vooon/smart-roller-gate-controller/README.md

# smart-roller-gate-controller
ESP32 based roller gate controller with ZigBee remotes
