vooon/smart-roller-gate-controller/hw/smart-roller-gate-controller/release/v1.0/brd-v1.0.pdf

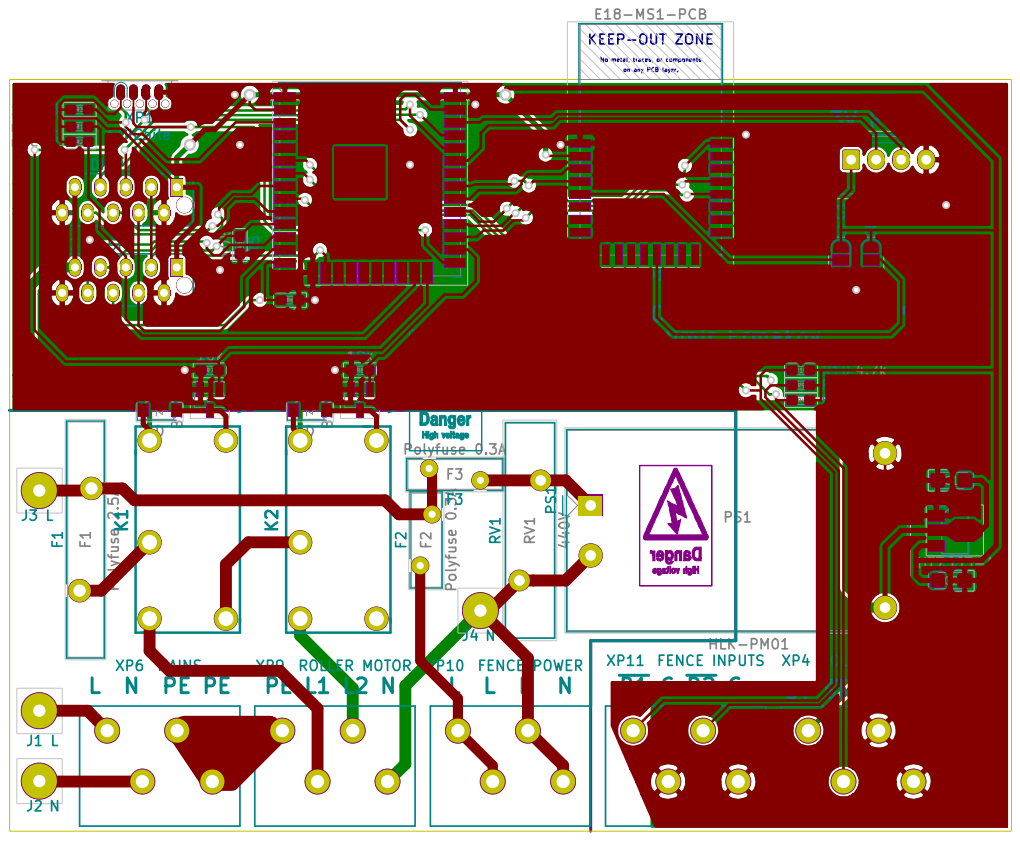
[picture p1: page 1]
