vooon/smart-roller-gate-controller/hw/smart-roller-gate-controller/release/v1.0/sch-v1.0.pdf

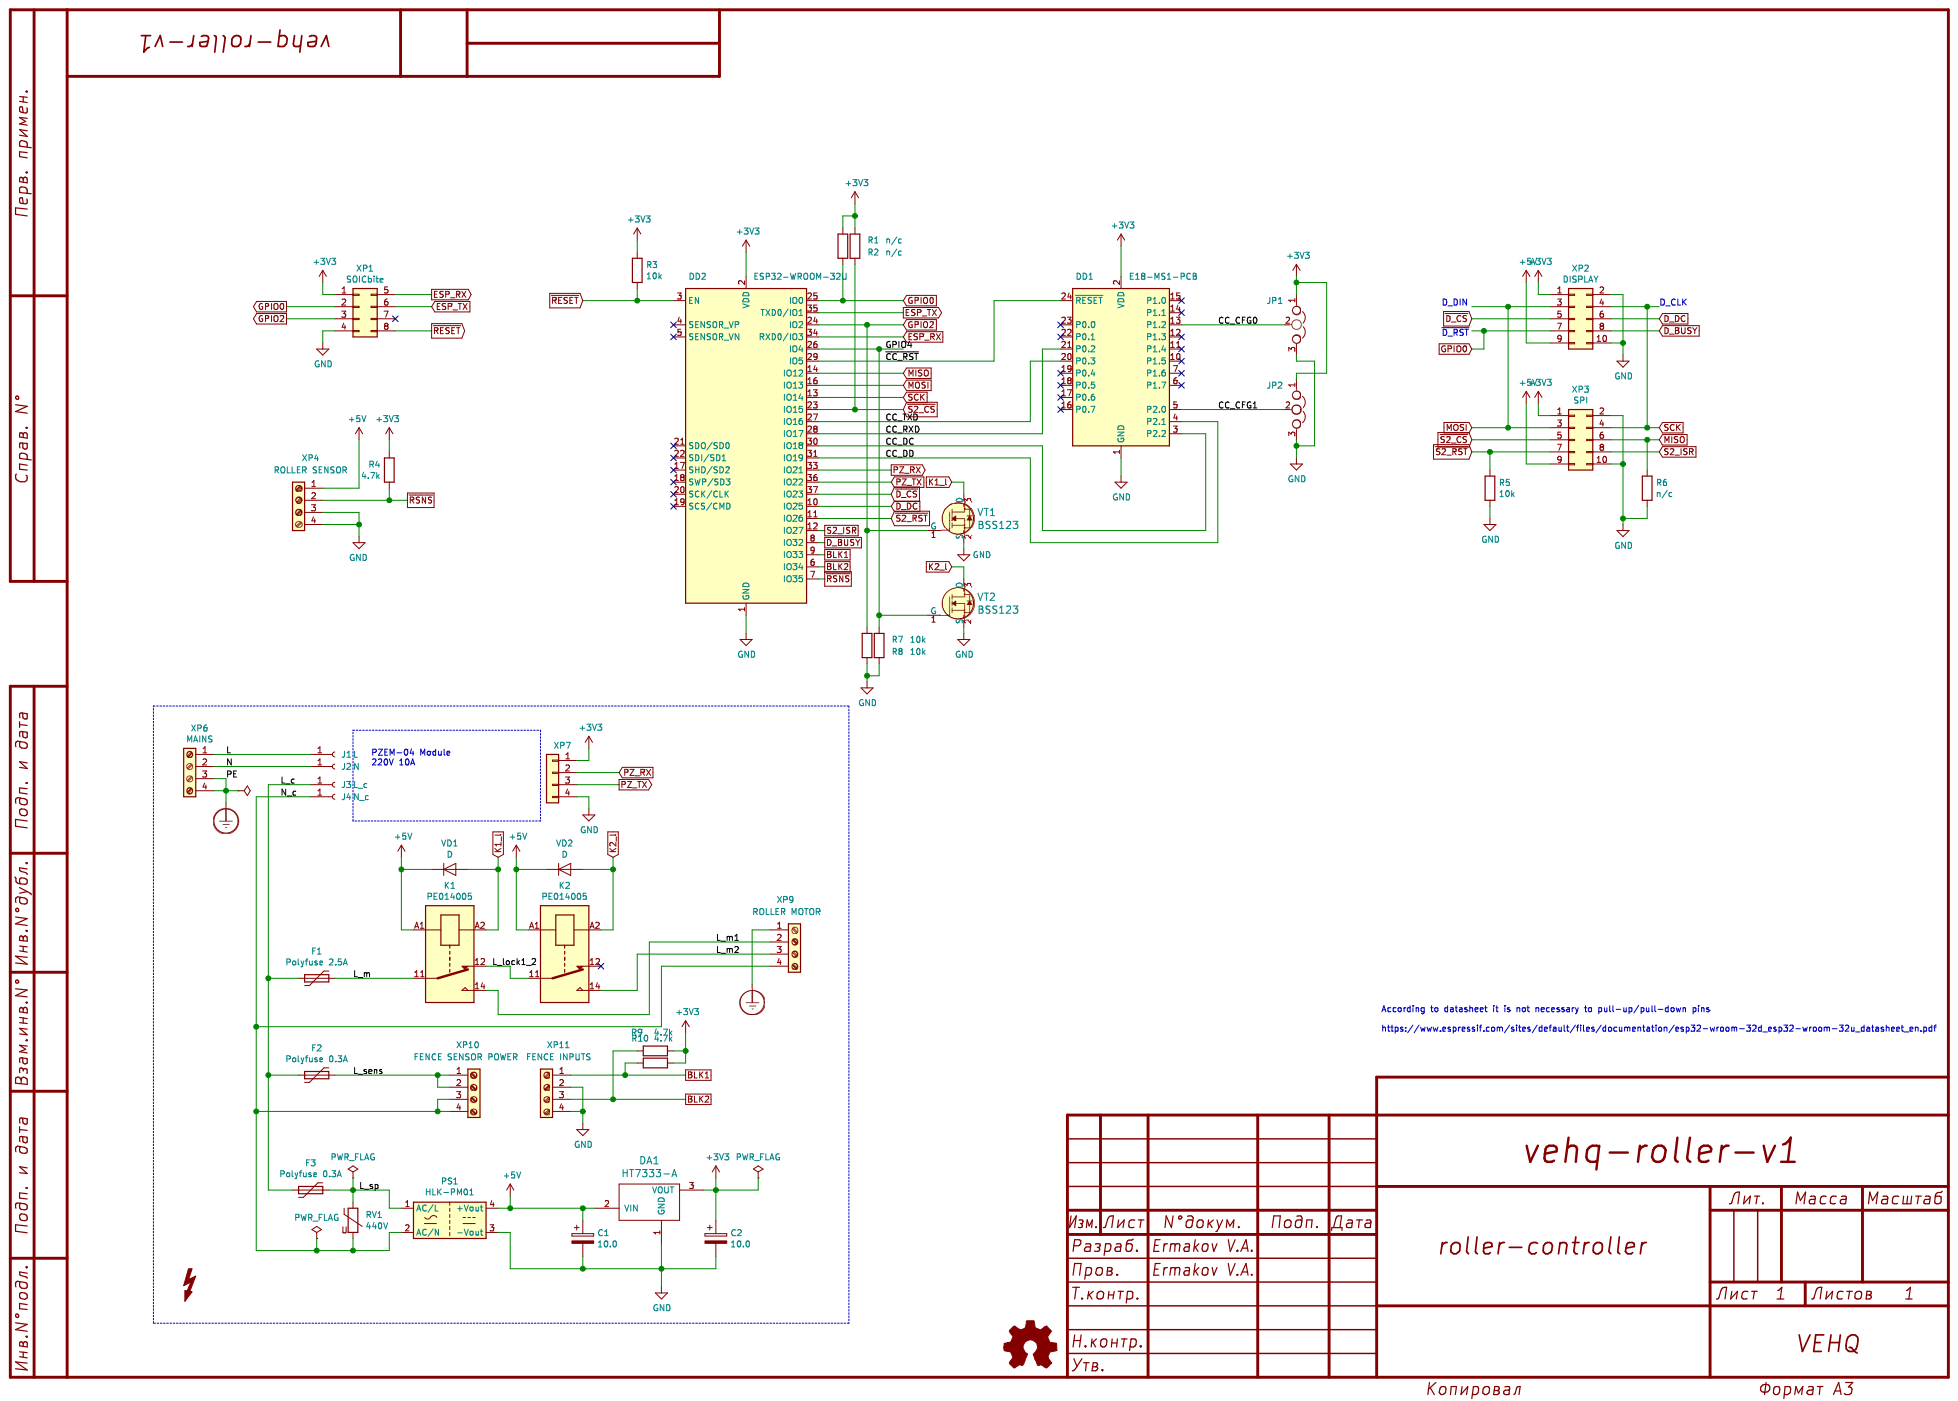
[picture p2: page 1]
