vooon/smart-roller-gate-controller/hw/smart-roller-gate-controller/smart-roller-gate-controller.kicad_pcb

## KiCad design hw/smart-roller-gate-controller/smart-roller-gate-controller.kicad_pcb (2020-01-26)

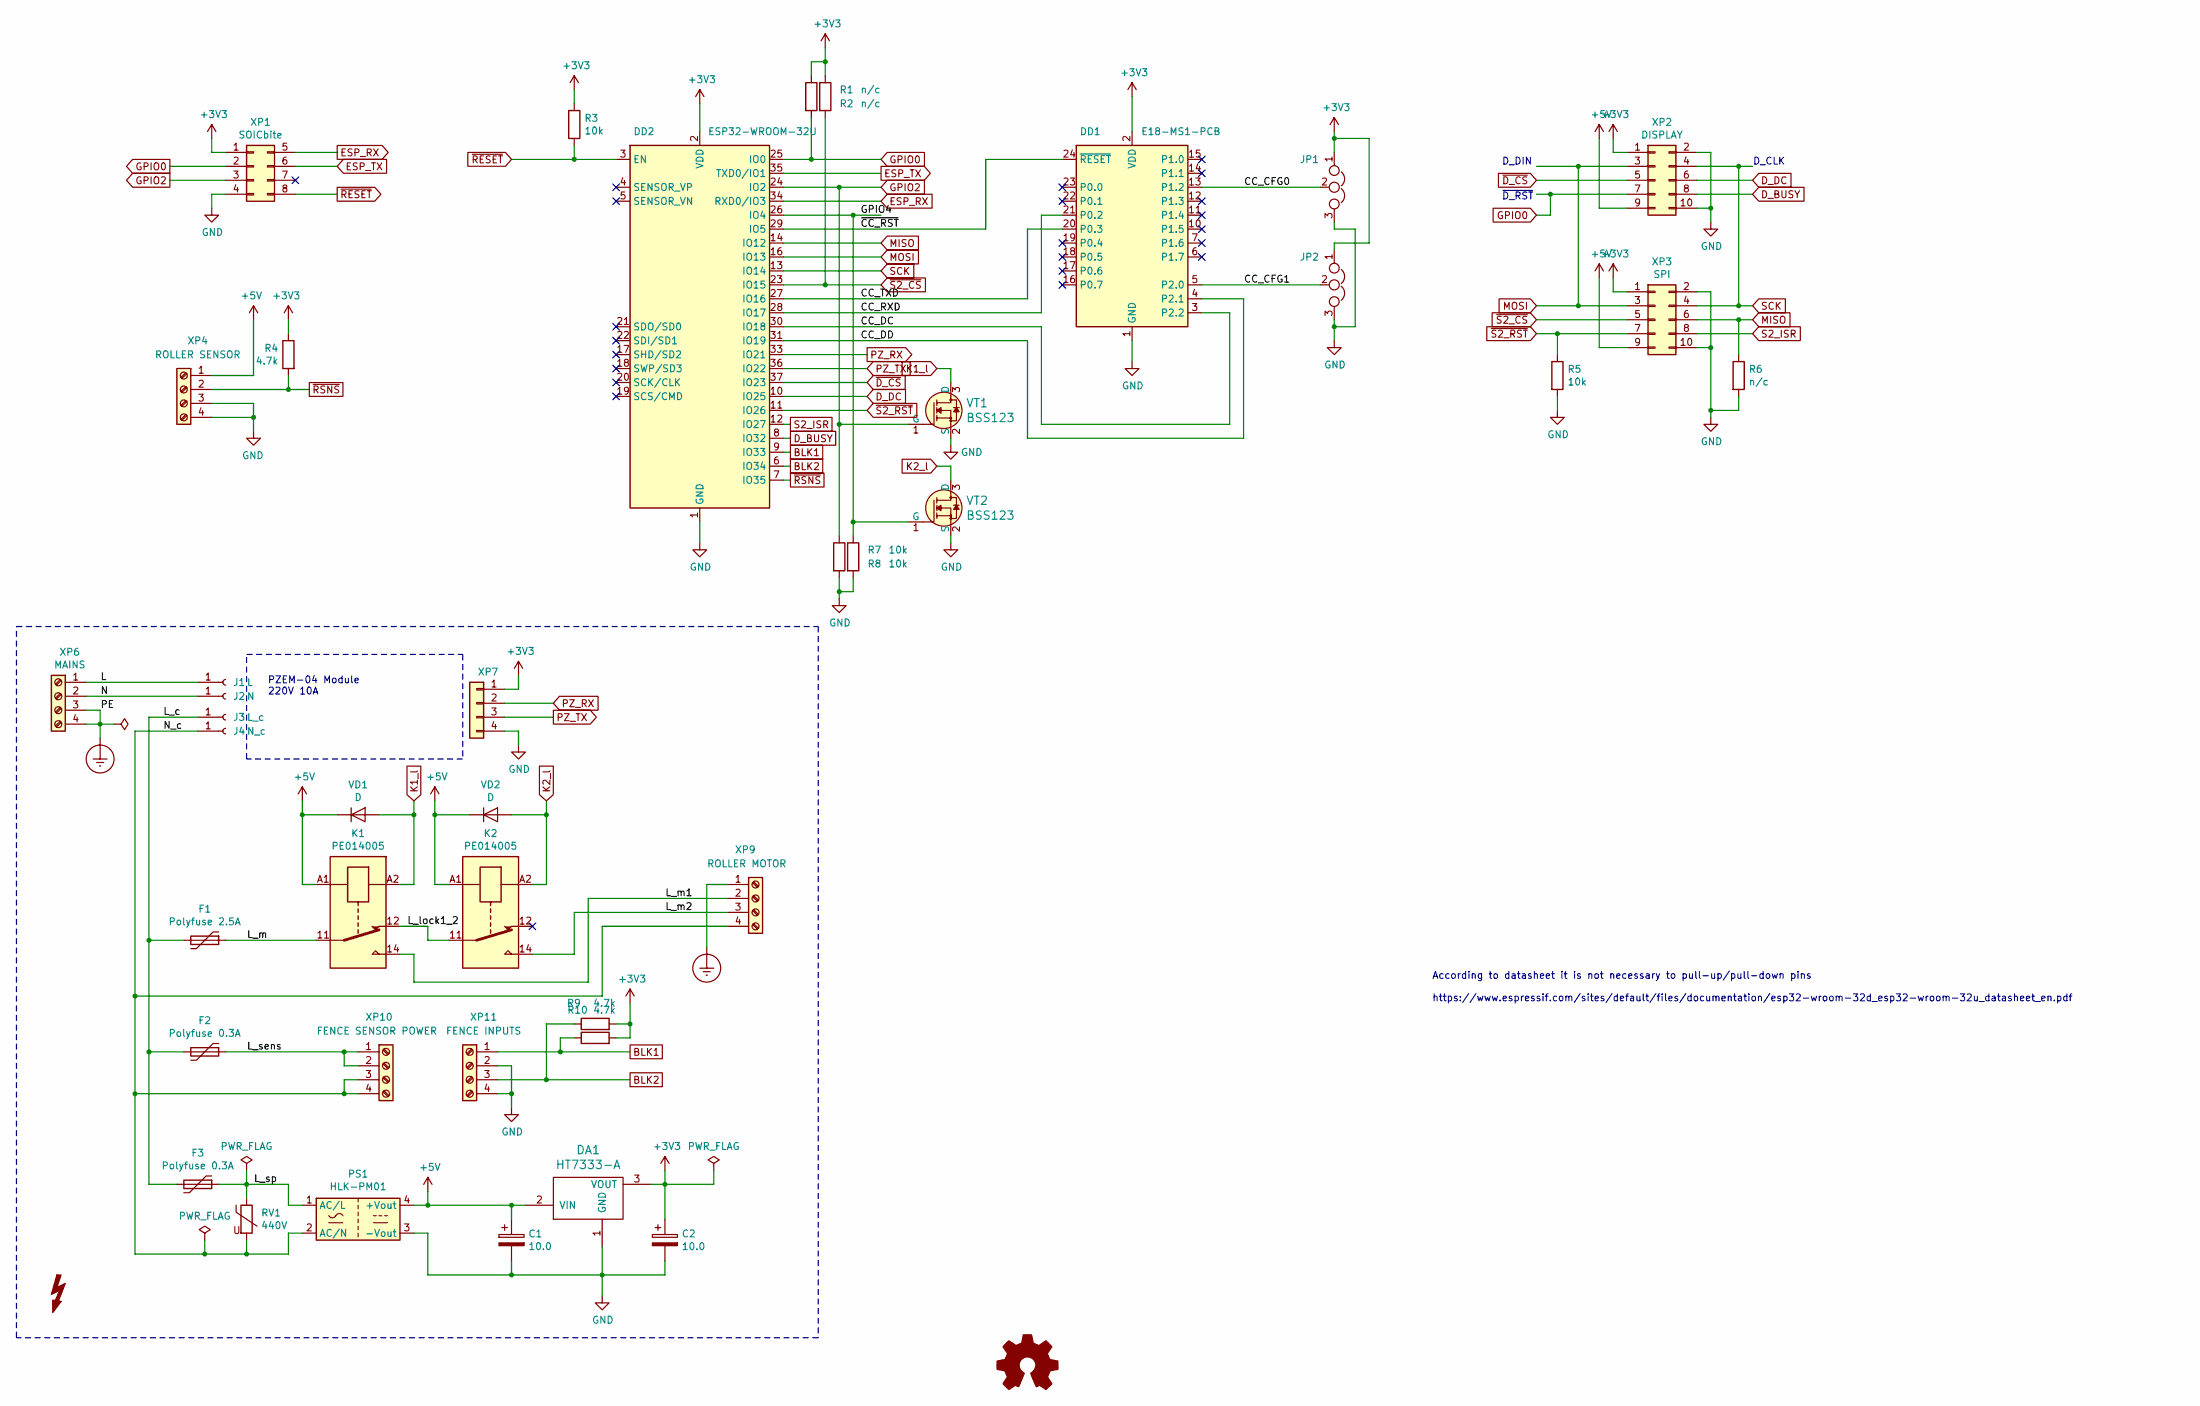
[picture p3: schematic smart-roller-gate-controller.sch, roller-controller]

Parts:
C1, C2: 10.0; CP_EIA-3216-10_Kemet-I
DA1: HT7333-A; SOT-89-3
DD1: E18-MS1-PCB
DD2: ESP32-WROOM-32U
F1: Polyfuse 2.5A; Fuse_Bourns_MF-RHT1300
F2, F3: Polyfuse 0.3A; Fuse_Bourns_MF-RHT200
J1: L; SolderWirePad_1x01_Drill1.2mm
J2: N; SolderWirePad_1x01_Drill1.2mm
J3: L_c; SolderWirePad_1x01_Drill1.2mm
J4: N_c; SolderWirePad_1x01_Drill1.2mm
JP1, JP2: Jumper_NC_Dual; SolderJumper-3_P1.3mm_Open_RoundedPad1.0x1.5mm
K1, K2: PE014005
PS1: HLK-PM01; Converter_ACDC_HiLink_HLK-PMxx
R1, R2, R6: n/c; R_0603_1608Metric_Pad1.05x0.95mm_HandSolder
R3, R5, R7, R8: 10k; R_0603_1608Metric_Pad1.05x0.95mm_HandSolder
R4, R9, R10: 4.7k; R_0603_1608Metric_Pad1.05x0.95mm_HandSolder
RV1: 440V; RV_Disc_D21.5mm_W4.9mm_P10mm
VD1, VD2: D; D_SOD-123
VT1, VT2: BSS123; SOT-23-3; MPN BSS123; Digi-Key_PN BSS123NCT-ND
XP1: SOICbite; SOIC_clipProgSmall
XP2: DISPLAY; CONN-TE-MICROMATCH-5X2-PTH-BOSS
XP3: SPI; CONN-TE-MICROMATCH-5X2-PTH-BOSS
XP4: ROLLER SENSOR; CONN-KF250-BA-4
XP6: MAINS; CONN-KF250-BA-4
XP7: Conn_01x04; JST_XH_B4B-XH-A_1x04_P2.50mm_Vertical
XP9: ROLLER MOTOR; CONN-KF250-BA-4
XP10: FENCE SENSOR POWER; CONN-KF250-BA-4
XP11: FENCE INPUTS; CONN-KF250-BA-4

Connections:
+3V3: C2.1, DA1.3 (VOUT), DD1.2 (VDD), DD2.2 (VDD), JP1.1, JP2.1, R1.1, R2.1, R3.1, R4.1, R9.2, R10.2, XP1.1, XP2.1, XP3.1, XP7.1
+5V: C1.1, DA1.2 (VIN), K1.A1, K2.A1, PS1.4 (+Vout), VD1.1 (K), VD2.1 (K), XP2.9, XP3.9, XP4.1
/CC_CFG0: DD1.13 (P1.2), JP1.2
/CC_CFG1: DD1.5 (P2.0), JP2.2
/CC_DC: DD1.3 (P2.2), DD2.30 (IO18)
/CC_DD: DD1.4 (P2.1), DD2.31 (IO19)
/CC_RXD: DD1.21 (P0.2), DD2.28 (IO17)
/CC_TXD: DD1.20 (P0.3), DD2.27 (IO16)
/GPIO4: DD2.26 (IO4), R8.1, VT2.1 (G)
/L: J1.1, XP6.1
/L_c: F1.2, F2.2, F3.2, J3.1
/L_lock1_2: K1.12, K2.11
/L_m: F1.1, K1.11
/L_m1: K1.14, XP9.2
/L_m2: K2.14, XP9.3
/L_sens: F2.1, XP10.1, XP10.2
/L_sp: F3.1, PS1.1 (AC/L), RV1.1
/N: J2.1, XP6.2
/N_c: J4.1, PS1.2 (AC/N), RV1.2, XP9.4, XP10.3, XP10.4
/~CC_RST: DD1.24 (~RESET), DD2.29 (IO5)
BLK1: DD2.9 (IO33), R10.1, XP11.1
BLK2: DD2.6 (IO34), R9.1, XP11.3
D_BUSY: DD2.8 (IO32), XP2.8
D_DC: DD2.10 (IO25), XP2.6
ESP_RX: DD2.34 (RXD0/IO3), XP1.5
ESP_TX: DD2.35 (TXD0/IO1), XP1.6
Earth_Protective: XP6.3, XP6.4, XP9.1
GND: C1.2, C2.2, DA1.1 (GND), DD1.1 (GND), DD2.1 (GND), DD2.15 (GND), DD2.38 (GND), JP1.3, JP2.3, PS1.3 (-Vout), R5.2, R6.2, R7.2, R8.2, VT1.2 (S), VT2.2 (S), XP1.4, XP2.2, XP2.10, XP3.2, XP3.10, XP4.3, XP4.4, XP7.4, XP11.2, XP11.4
GPIO0: DD2.25 (IO0), R1.2, XP1.2, XP2.7
GPIO2: DD2.24 (IO2), R7.1, VT1.1 (G), XP1.3
K1_l: K1.A2, VD1.2 (A), VT1.3 (D)
K2_l: K2.A2, VD2.2 (A), VT2.3 (D)
MISO: DD2.14 (IO12), R6.1, XP3.6
MOSI: DD2.16 (IO13), XP2.3, XP3.3
PZ_RX: DD2.33 (IO21), XP7.2
PZ_TX: DD2.36 (IO22), XP7.3
S2_ISR: DD2.12 (IO27), XP3.8
SCK: DD2.13 (IO14), XP2.4, XP3.4
~D_CS: DD2.37 (IO23), XP2.5
~RESET: DD2.3 (EN), R3.2, XP1.8
~RSNS: DD2.7 (IO35), R4.2, XP4.2
~S2_CS: DD2.23 (IO15), R2.2, XP3.5
~S2_RST: DD2.11 (IO26), R5.1, XP3.7

Notes on the sheet:
PZEM-04 Module 220V 10A
According to datasheet it is not necessary to pull-up/pull-down pins https://www.espressif.com/sites/default/files/documentation/esp32-wroom-32d_esp32-wroom-32u_datasheet_en.pdf
D_DIN
~D_RST
D_CLK

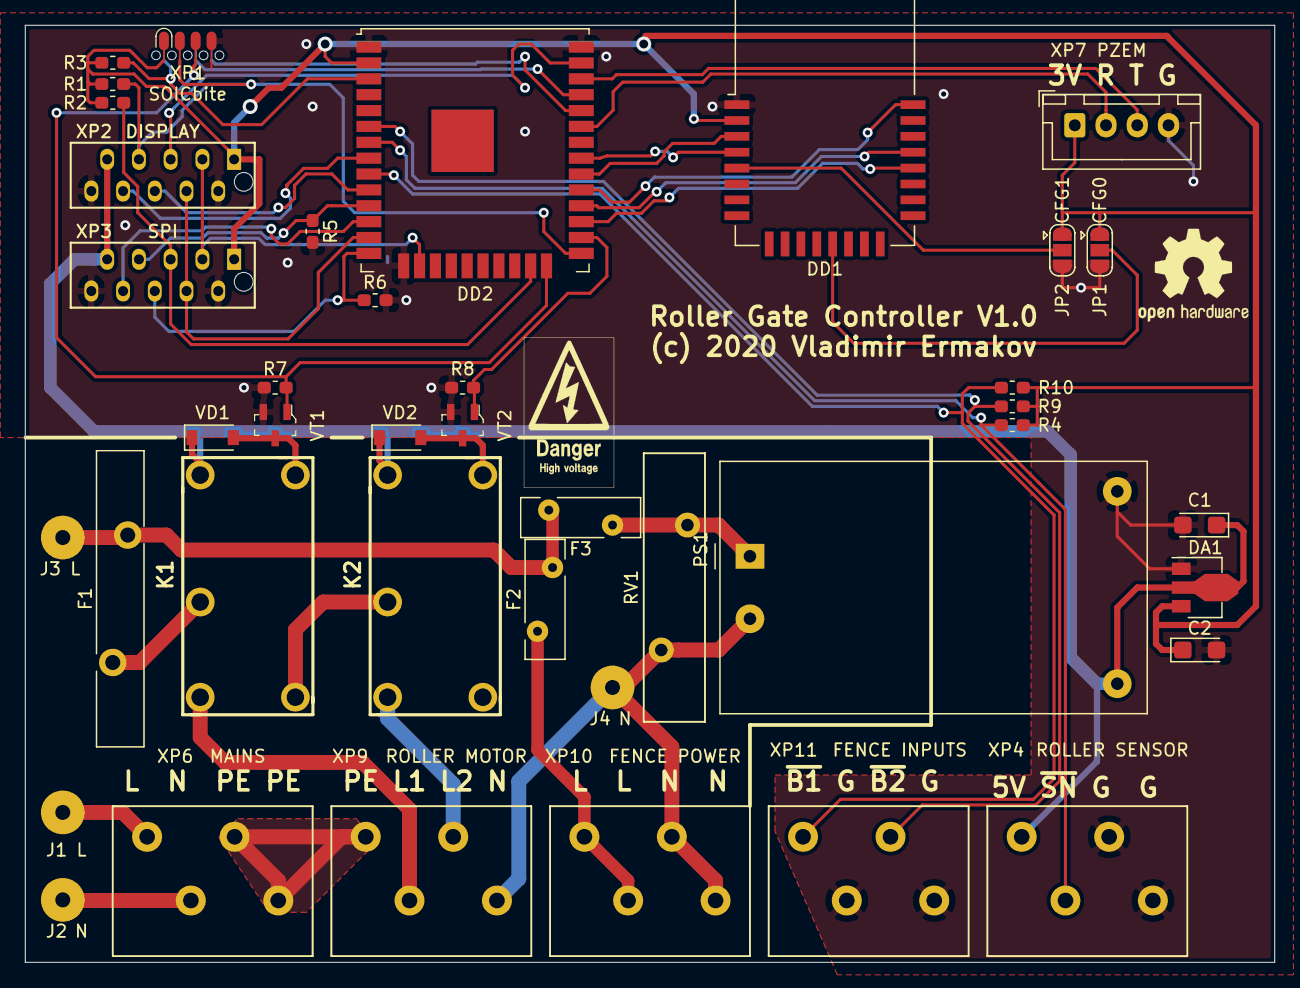
[picture p4: board smart-roller-gate-controller.kicad_pcb from above]

Board: 2 copper layers, 100.0 x 75.0 mm, 41 parts (0 on the bottom side), 43 nets.
