vooon/smart-roller-gate-controller/(commit log)

2020-01-19 hw: connect esp32 and cc2530
    [smart-roller-gate-controller.kicad_pcb, smart-roller-gate-controller.sch]
2020-01-19 hw: HLK-PM01 and HT7333 psu
    [smart-roller-gate-controller.sch]
2020-01-19 hw: mostly done hv sch
    [smart-roller-gate-controller.sch]
2020-01-20 hw: add debug connector
    [smart-roller-gate-controller.sch]
2020-01-20 hw: connect more patrs
    [smart-roller-gate-controller.sch]
2020-01-20 hw: sch complete, alpha version
    [smart-roller-gate-controller.sch]
2020-01-20 hw: optimize pinout a bit
    [smart-roller-gate-controller.sch]
2020-01-20 hw: start routing
    [smart-roller-gate-controller.kicad_pcb, smart-roller-gate-controller.sch]
2020-01-20 hw: initial placement
    [smart-roller-gate-controller.kicad_pcb, smart-roller-gate-controller.sch]
2020-01-25 hw: done initial placement
    [smart-roller-gate-controller.kicad_pcb, smart-roller-gate-controller.sch]
2020-01-26 hw: initial traces
    [smart-roller-gate-controller.kicad_pcb]
2020-01-26 hw: done v1.0
    [smart-roller-gate-controller.kicad_pcb]
2020-01-26 hw: add pcb production file for v1.0
    [smart-roller-gate-controller-B_Cu.gbr, smart-roller-gate-controller-B_Mask.gbr, smart-roller-gate-controller-B_Paste.gbr, smart-roller-gate-controller-B_SilkS.gbr, smart-roller-gate-controller-Edge_Cuts.gbr, smart-roller-gate-controller-F_Cu.gbr, smart-roller-gate-controller-F_Mask.gbr, smart-roller-gate-controller-F_Paste.gbr]
2020-04-11 sw: add names for motor switches
2020-04-11 sw: make a common scripts for open/close/stop single and two buttons
2020-04-11 sw: make repeated press for Open/Close buttons possible. To Stop need to press opposete button
2020-04-11 sw: add device_class for blk1
2020-05-17 update config to use wifi_networks secret, add secters sample file
2020-06-07 finally remove pzem, buggy sensor and unneded
2020-06-07 add switch to temporary disable blk1 (in some weather conditions sensor behaves badly)
2020-06-07 add ability to disable physical open/close button
