vooon/smart-roller-gate-controller/(notices)

Notices in the files:
hw/smart-roller-gate-controller/smart-roller-gate-controller.kicad_pcb:
(c) 2020 Vladimir Ermakov
